DMPRO-Gruppe-B/Effect-Box-PCB/README.md

# Effect-Box-PCB

View this project on [CADLAB.io](https://cadlab.io/project/2128).
