DMPRO-Gruppe-B/Effect-Box-PCB/Effect-Box_bom_status.ods

Done? | Description | References | Value | Footprint | Quantity Per PCB
Done | Unpolarized capacitor | C_iovdd_0 C_iovdd_3 C_iovdd_5 C_vdd_1 | 0.1 µF | C_1206_3216Metric_Pad1.42x1.75mm_HandSolder | 4
Done | Unpolarized capacitor | C27 C31 C35 C38 C39 C41 C42 C44 C45 C46 C47 C49 C51 C53 C55 C57 C59 | 0.47u | C_1206_3216Metric_Pad1.42x1.75mm_HandSolder | 17
Done | Unpolarized capacitor | C_btn_0 C_btn_1 C_btn_2 C_btn_3 C_btn_4 C_btn_5 | 1 nF | C_1206_3216Metric_Pad1.42x1.75mm_HandSolder | 6
Done |  | C_dec1 | 1 µF | C_1206_3216Metric_Pad1.42x1.75mm_HandSolder | 1
Done | Unpolarized capacitor | C_avdd_0 C_avdd_1 | 10 nF | C_1206_3216Metric_Pad1.42x1.75mm_HandSolder | 2
Done | Unpolarized capacitor | C_avdd1 C_iovdd1 C_vdd1 | 10 µF | C_1206_3216Metric_Pad1.42x1.75mm_HandSolder | 3
Done | Unpolarized capacitor | C_disp_1 C_disp_2 C_reset1 | 100 nF | C_1206_3216Metric_Pad1.42x1.75mm_HandSolder | 3
Done | Unpolarized capacitor | C5 C6 C10 C12 C13 C15 C17 C20 C25 C67 C69 C77 C78 | 100n | C_1206_3216Metric_Pad1.42x1.75mm_HandSolder | 13
Done | Unpolarized capacitor | C22 | 100u | C_1206_3216Metric_Pad1.42x1.75mm_HandSolder | 1
Done | Unpolarized capacitor | C8 C9 C14 C64 C65 | 10u | C_1206_3216Metric_Pad1.42x1.75mm_HandSolder | 5
Done | Polarized capacitor, small US symbol | C70 C75 C76 | 10u | C_1206_3216Metric_Pad1.42x1.75mm_HandSolder | 3
Done |  | C_crystal_1 C_crystal_2 | 12 pF | C_1206_3216Metric_Pad1.42x1.75mm_HandSolder | 2
Done | Unpolarized capacitor | C11 C61 C66 C68 | 1u | C_1206_3216Metric_Pad1.42x1.75mm_HandSolder | 4
Done | Polarized capacitor, small US symbol | C71 | 1u | C_1206_3216Metric_Pad1.42x1.75mm_HandSolder | 1
Done | Unpolarized capacitor | C1 | 220n | C_1206_3216Metric_Pad1.42x1.75mm_HandSolder | 1
Done | Unpolarized capacitor | C2 C4 C16 C18 C19 C62 | 22u | C_1206_3216Metric_Pad1.42x1.75mm_HandSolder | 6
Done | Unpolarized capacitor | C7 | 3.3n | C_1206_3216Metric_Pad1.42x1.75mm_HandSolder | 1
Done | Unpolarized capacitor | C21 | 330u | C_1206_3216Metric_Pad1.42x1.75mm_HandSolder | 1
Done | Unpolarized capacitor | C26 C28 C30 C32 C33 C34 C36 C37 C40 C43 | 4.7u | C_1206_3216Metric_Pad1.42x1.75mm_HandSolder | 10
Done | Polarized capacitor, small US symbol | C72 C73 C74 C79 C80 | 4.7u | C_1206_3216Metric_Pad1.42x1.75mm_HandSolder | 5
Done | Unpolarized capacitor | C23 C24 C29 | 47u | C_1206_3216Metric_Pad1.42x1.75mm_HandSolder | 3
Done | Unpolarized capacitor | C3 C81 | 5p | C_1206_3216Metric_Pad1.42x1.75mm_HandSolder | 2
Done |  | Crystal_GND24 | 48MHz | Crystal_SMD_Abracon_ABM8G-4Pin_3.2x2.5mm | 1
Done | Light emitting diode | D1 | LED1 | LED_0805_2012Metric_Pad1.15x1.40mm_HandSolder | 1
Done | Light emitting diode | D2 | LED2 | LED_0805_2012Metric_Pad1.15x1.40mm_HandSolder | 1
Done | Ferrite bead | FB1 | Ferrite_Bead | BLM21AG102SN1D | 1
Done |  | J2 J6 | 26642801RP2 | PinHeader_2x14_P2.54mm_Vertical | 2
Done | Audio Jack, 3 Poles (Stereo / TRS) | J7 J8 | AudioJack3 | Jack_3.5mm_CUI_SJ-3523-SMT_Horizontal | 2
Done | Generic connector, double row, 02x07, odd/even pin numbering scheme (row 1 odd numbers, row 2 even numbers), script generated (kicad-library-utils/schlib/autogen/connector/) | J1 | Conn_02x07_Odd_Even | PinHeader_2x07_P2.00mm_Vertical | 1
Done |  | J5 | Conn_ARM_JTAG_SWD_20 | PinHeader_2x10_P2.54mm_Vertical | 1
Done |  | J3 | FH12A-10S-0.5SH55 | FH12A-10S-0.5SH55 | 1
Done |  | J9 | PJ-006A-SMT | CUI_PJ-006A-SMT | 1
Done | Generic connector, single row, 01x08, script generated (kicad-library-utils/schlib/autogen/connector/) | J10 | Power pins | PinHeader_1x08_P2.54mm_Vertical | 1
Done | Inductor | L1 L2 | 1.5u | IND_VLS5045EX-4R7M | 2
Done | Inductor | L3 | 2.2u | IND_VLS5045EX-4R7M | 1
Done | Resistor | R9 | 1 | R_1206_3216Metric_Pad1.42x1.75mm_HandSolder | 1
Done | Resistor | R_btn_up_0 R_btn_up_1 R_btn_up_2 R_btn_up_3 R_btn_up_4 R_btn_up_5 | 1 MΩ | R_1206_3216Metric_Pad1.42x1.75mm_HandSolder | 6
Done | Resistor | R_disp1 | 10 MΩ | R_1206_3216Metric_Pad1.42x1.75mm_HandSolder | 1
Done | Resistor | R_btn_0 R_btn_1 R_btn_2 R_btn_3 R_btn_4 R_btn_5 R_reset1 | 100 Ω | R_1206_3216Metric_Pad1.42x1.75mm_HandSolder | 7
Done | Resistor | R5 R6 R18 R19 | 100k | R_1206_3216Metric_Pad1.42x1.75mm_HandSolder | 4
Done | Resistor | R10 R11 | 10k | R_1206_3216Metric_Pad1.42x1.75mm_HandSolder | 2
Done | Resistor | R15 | 2.4k | R_1206_3216Metric_Pad1.42x1.75mm_HandSolder | 1
Done | Resistor | R2 R4 R8 | 22.1k | R_1206_3216Metric_Pad1.42x1.75mm_HandSolder | 3
Done | Resistor | R1 | 30.1k | R_1206_3216Metric_Pad1.42x1.75mm_HandSolder | 1
Done | Resistor | R14 | 330 | R_1206_3216Metric_Pad1.42x1.75mm_HandSolder | 1
Done | Resistor | R12 R13 R16 R17 | 4.7k | R_1206_3216Metric_Pad1.42x1.75mm_HandSolder | 4
Done | Resistor | R3 | 6.81k | R_1206_3216Metric_Pad1.42x1.75mm_HandSolder | 1
Done | Resistor | R7 | 73.2k | R_1206_3216Metric_Pad1.42x1.75mm_HandSolder | 1
Done | Resistor | R_LED_1 R_LED_2 | 82 Ω | R_1206_3216Metric_Pad1.42x1.75mm_HandSolder | 2
Done |  | SW0 SW1 SW2 SW3 SW4 SW5 SW6 | SW_Push | FSMSMTR | 7
Done |  | U7 | EFM32GG942F1024 | EFM32GG942F1024 | 1
Done |  | U8 | INA1651IPW | TSSOP-14_4.4x5mm_P0.65mm | 1
Done |  | U10 | LM7805SX_NOPB | LM7805SX&slash_NOPB | 1
Done |  | U9 | PCM3003E | SSOP-24_5.3x8.2mm_P0.65mm | 1
Done |  | U4 | S25FL1 | SOIC-8_5.275x5.275mm_P1.27mm | 1
Done |  | U5 | SiT2024B | SOT-23-5_HandSoldering | 1
Done |  | U2 | TPS54294 | TPS54294PWPR | 1
Done |  | U1 | TPS54325 | TPS54325PWPR | 1
Done | Artix 7 T 100 XC7A100T-FTG256 | U3 | XC7A100T-FTG256 | Xilinx_FTG256 | 1
 | 59
 | 161
 | 161
 | 1
 | 161
 | default
 | ti. 08. okt. 2019 kl. 12.55 +0200
 | /home/hon/Projects/GitHub/DMPRO-Gruppe-B/Effect-Box-PCB/Effect-Box.sch
 | Eeschema 5.1.4-e60b266~84~ubuntu19.04.1
