DMPRO-Gruppe-B/Effect-Box-PCB/(threads)

Thread 14 (2019-09-18):

Communication between FPGA and DAC/ADC

minatst, 2019-09-18:

HON95, 2019-10-01:
Done?

jonassa, 2019-10-01:
Njæ, må implementeres i chisel

On Tue, Oct 1, 2019, 13:52 Håvard O. Nordstrand <notifications@github.com>
wrote:

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

HON95, 2019-10-01:
Men PCB-delen er done? Siden issuen er i Effect-Box-PCB.

jonassa, 2019-10-01:
Ja, sant :)

Closed 2019-10-01.

Thread 17 (2019-09-18):

Decide on footprints for resistors, capacitors, coils etc

minatst, 2019-09-18:

kalkins, 2019-09-20:
It's easier to have the same package for all of the same kind of component. It should be a package that is easy to solder by hand. Size doesn't matter that much, we have room

HON95, 2019-09-24:
Finding electrolytical capacitors and inductors (at DigiKey) with matching footprints is hard ... See Handleliste.

Closed 2019-09-26.

Thread 18 (2019-09-20):

Footprints for switching converters

kalkins, 2019-09-20:
The switching converters weren't in the KiCad library, so they had to be manually drawn. That means that they don't have a built-in footprint either, so we have to find one. The easiest is to use a standard package.

Closed 2019-09-24.
