DMPRO-Gruppe-B/Effect-Box-PCB/Effect-Box.kicad_pcb

## KiCad design Effect-Box.kicad_pcb (2019-10-09)

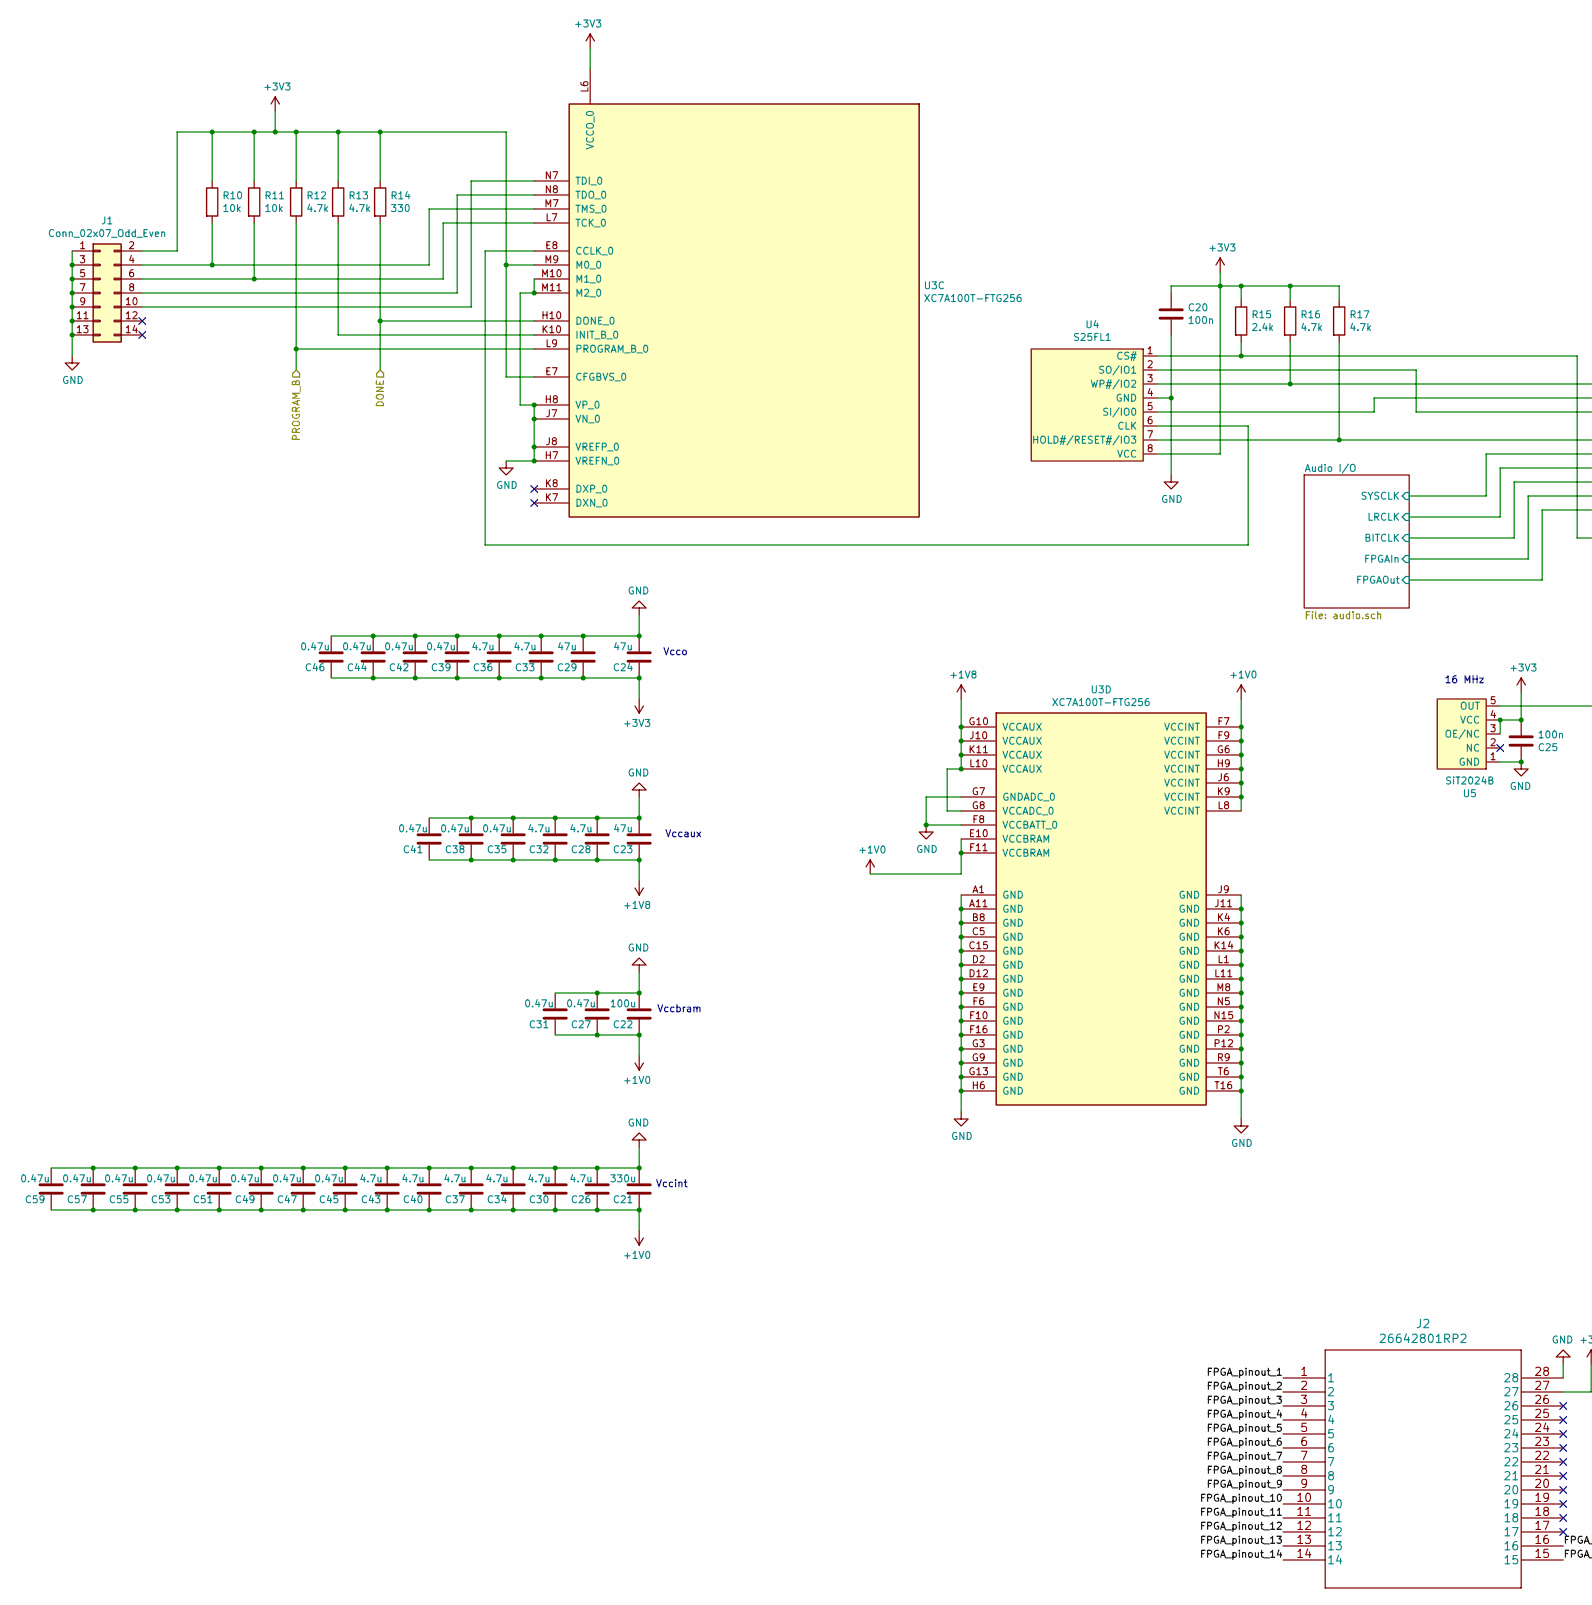
[picture p1: schematic FPGA.sch, part in row 1, column 1]

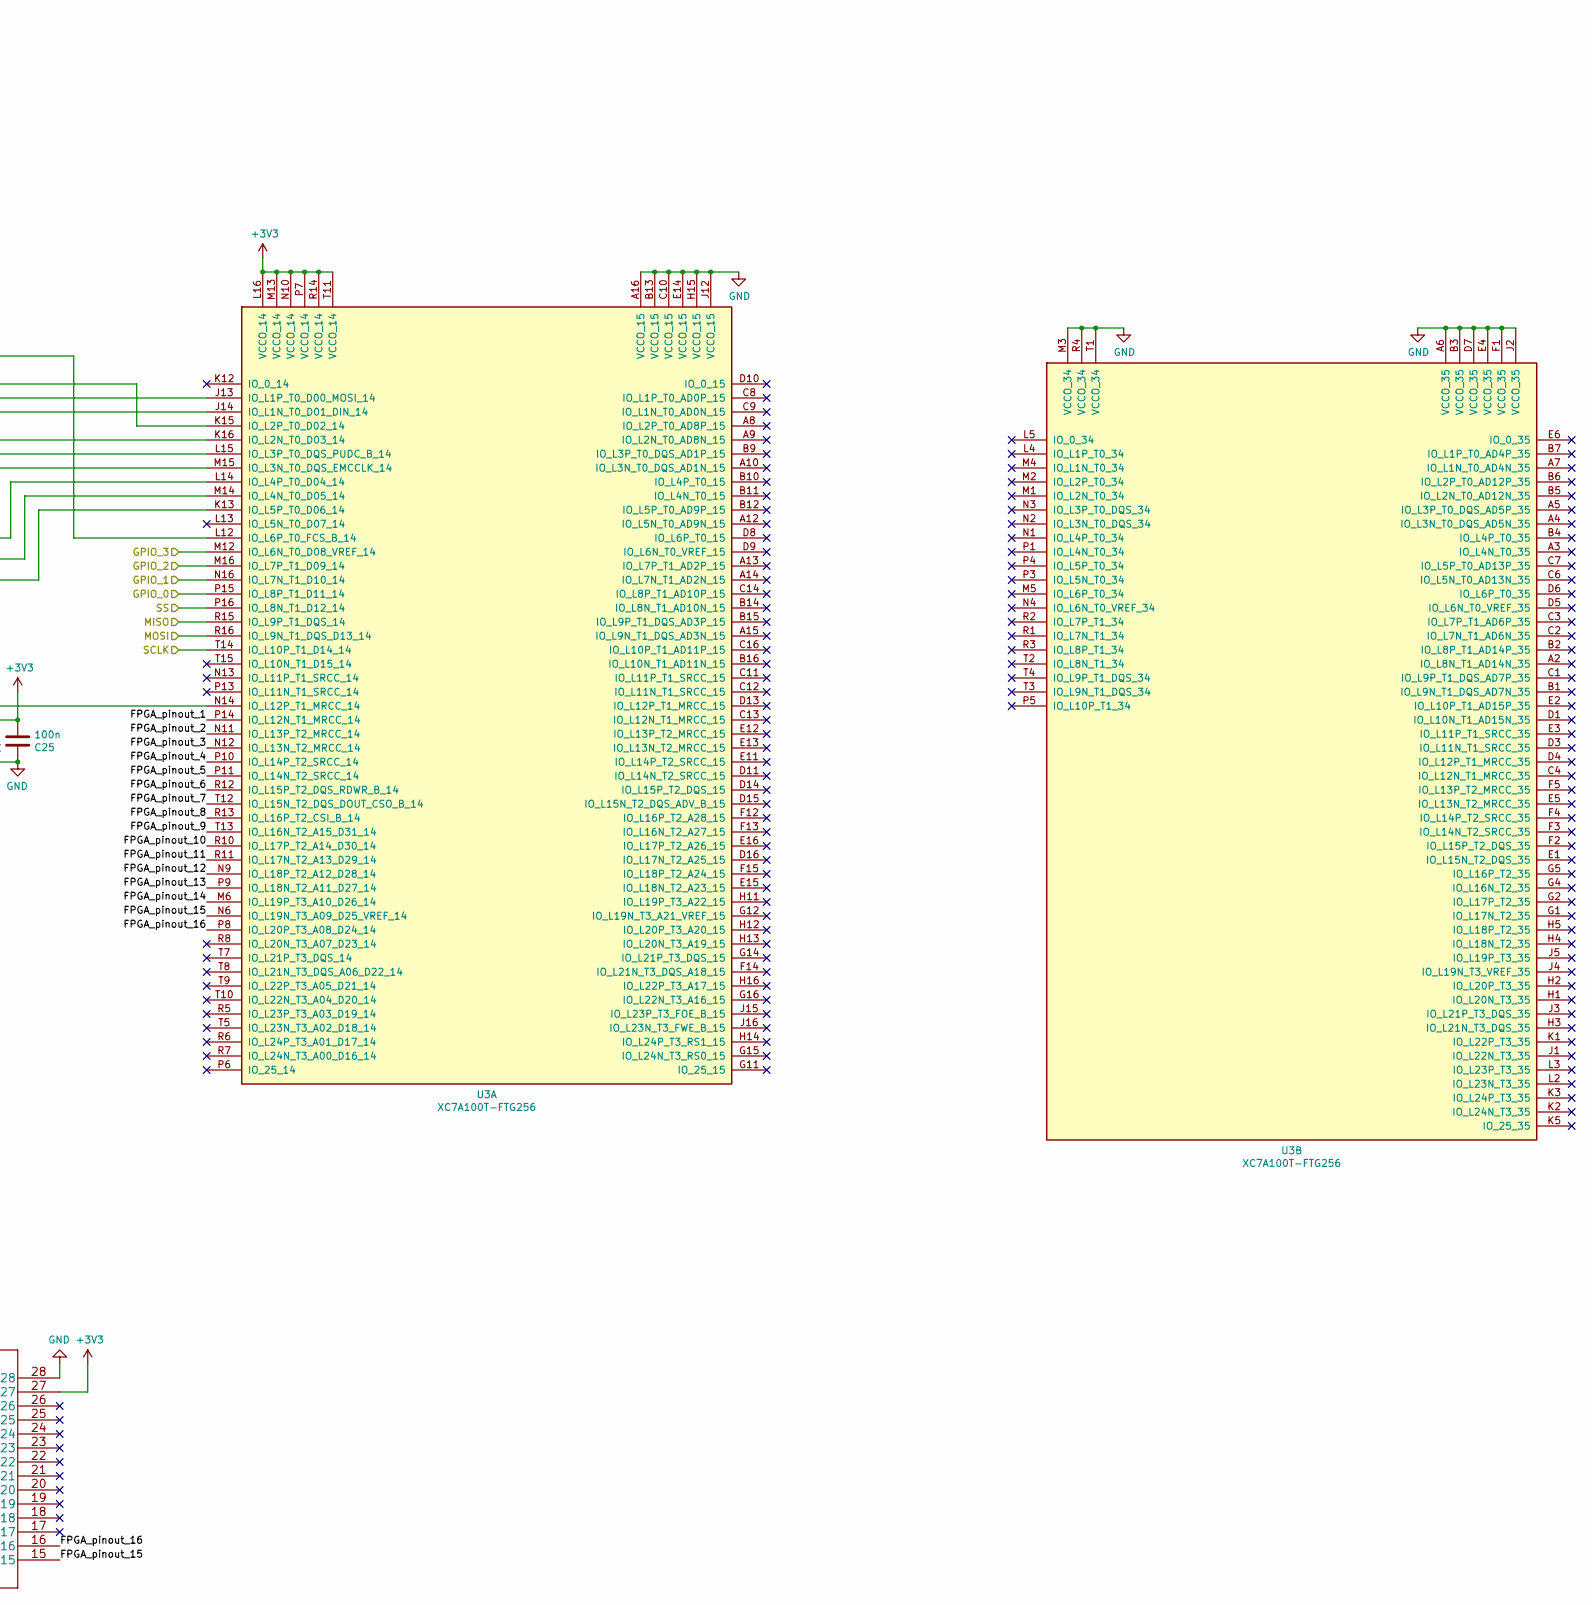
[picture p2: schematic FPGA.sch, part in row 1, column 2]

Parts:
C20, C25: 100n; C_1206_3216Metric_Pad1.42x1.75mm_HandSolder
C21: 330u; C_1206_3216Metric_Pad1.42x1.75mm_HandSolder
C22: 100u; C_1206_3216Metric_Pad1.42x1.75mm_HandSolder
C23, C24, C29: 47u; C_1206_3216Metric_Pad1.42x1.75mm_HandSolder
C26, C28, C30, C32, C33, C34, C36, C37, C40, C43: 4.7u; C_1206_3216Metric_Pad1.42x1.75mm_HandSolder
C27, C31, C35, C38, C39, C41, C42, C44, C45, C46, C47, C49, C51, C53, C55, C57, C59: 0.47u; C_1206_3216Metric_Pad1.42x1.75mm_HandSolder
J1: Conn_02x07_Odd_Even; PinHeader_2x07_P2.00mm_Vertical
J2: 26642801RP2; PinHeader_2x14_P2.54mm_Vertical
R10, R11: 10k; R_1206_3216Metric_Pad1.42x1.75mm_HandSolder
R12, R13, R16, R17: 4.7k; R_1206_3216Metric_Pad1.42x1.75mm_HandSolder
R14: 330; R_1206_3216Metric_Pad1.42x1.75mm_HandSolder
R15: 2.4k; R_1206_3216Metric_Pad1.42x1.75mm_HandSolder
U3: XC7A100T-FTG256; Xilinx_FTG256
U4: S25FL1; SOIC-8_5.275x5.275mm_P1.27mm
U5: SiT2024B; SOT-23-5_HandSoldering

Connections:
+1V0: C21.1, C22.1, C26.1, C27.1, C30.1, C31.1, C34.1, C37.1, C40.1, C43.1, C45.1, C47.1, C49.1, C51.1, C53.1, C55.1, C57.1, C59.1, U3.E10 (VCCBRAM), U3.F7 (VCCINT), U3.F9 (VCCINT), U3.F11 (VCCBRAM), U3.G6 (VCCINT), U3.H9 (VCCINT), U3.J6 (VCCINT), U3.K9 (VCCINT), U3.L8 (VCCINT); also elsewhere on the board
+1V8: C23.1, C28.1, C32.1, C35.1, C38.1, C41.1, U3.G8 (VCCADC_0), U3.G10 (VCCAUX), U3.J10 (VCCAUX), U3.K11 (VCCAUX), U3.L10 (VCCAUX); also elsewhere on the board
/FPGA/Audio I/O/BITCLK: U3.L14 (IO_L4P_T0_D04_14); also elsewhere on the board
/FPGA/Audio I/O/FPGAIn: U3.M14 (IO_L4N_T0_D05_14); also elsewhere on the board
/FPGA/Audio I/O/FPGAOut: U3.K13 (IO_L5P_T0_D06_14); also elsewhere on the board
/FPGA/Audio I/O/LRCLK: U3.M15 (IO_L3N_T0_DQS_EMCCLK_14); also elsewhere on the board
/FPGA/Audio I/O/SYSCLK: U3.L15 (IO_L3P_T0_DQS_PUDC_B_14); also elsewhere on the board
/FPGA/DONE: R14.2, U3.H10 (DONE_0); also elsewhere on the board
/FPGA/FPGA_pinout_1: J2.1, U3.P14 (IO_L12N_T1_MRCC_14)
/FPGA/FPGA_pinout_2: J2.2, U3.N11 (IO_L13P_T2_MRCC_14)
/FPGA/FPGA_pinout_3: J2.3, U3.N12 (IO_L13N_T2_MRCC_14)
/FPGA/FPGA_pinout_4: J2.4, U3.P10 (IO_L14P_T2_SRCC_14)
/FPGA/FPGA_pinout_5: J2.5, U3.P11 (IO_L14N_T2_SRCC_14)
/FPGA/FPGA_pinout_6: J2.6, U3.R12 (IO_L15P_T2_DQS_RDWR_B_14)
/FPGA/FPGA_pinout_7: J2.7, U3.T12 (IO_L15N_T2_DQS_DOUT_CSO_B_14)
/FPGA/FPGA_pinout_8: J2.8, U3.R13 (IO_L16P_T2_CSI_B_14)
/FPGA/FPGA_pinout_9: J2.9, U3.T13 (IO_L16N_T2_A15_D31_14)
/FPGA/FPGA_pinout_10: J2.10, U3.R10 (IO_L17P_T2_A14_D30_14)
/FPGA/FPGA_pinout_11: J2.11, U3.R11 (IO_L17N_T2_A13_D29_14)
/FPGA/FPGA_pinout_12: J2.12, U3.N9 (IO_L18P_T2_A12_D28_14)
/FPGA/FPGA_pinout_13: J2.13, U3.P9 (IO_L18N_T2_A11_D27_14)
/FPGA/FPGA_pinout_14: J2.14, U3.M6 (IO_L19P_T3_A10_D26_14)
/FPGA/FPGA_pinout_15: J2.15, U3.N6 (IO_L19N_T3_A09_D25_VREF_14)
/FPGA/FPGA_pinout_16: J2.16, U3.P8 (IO_L20P_T3_A08_D24_14)
/FPGA/GPIO_0: U3.P15 (IO_L8P_T1_D11_14); also elsewhere on the board
/FPGA/GPIO_1: U3.N16 (IO_L7N_T1_D10_14); also elsewhere on the board
/FPGA/GPIO_2: U3.M16 (IO_L7P_T1_D09_14); also elsewhere on the board
/FPGA/GPIO_3: U3.M12 (IO_L6N_T0_D08_VREF_14); also elsewhere on the board
/FPGA/MISO: U3.R15 (IO_L9P_T1_DQS_14); also elsewhere on the board
/FPGA/MOSI: U3.R16 (IO_L9N_T1_DQS_D13_14); also elsewhere on the board
/FPGA/PROGRAM_B: R12.1, U3.L9 (PROGRAM_B_0); also elsewhere on the board
/FPGA/SCLK: U3.T14 (IO_L10P_T1_D14_14); also elsewhere on the board
/FPGA/SS: U3.P16 (IO_L8N_T1_D12_14); also elsewhere on the board
GND: C20.2, C21.2, C22.2, C23.2, C24.2, C25.1, C26.2, C27.2, C28.2, C29.2, C30.2, C31.2, C32.2, C33.2, C34.2, C35.2, C36.2, C37.2, C38.2, C39.2, C40.2, C41.2, C42.2, C43.2, C44.2, C45.2, C46.2, C47.2, C49.2, C51.2, C53.2, C55.2, C57.2, C59.2, J1.1, J1.3, J1.5, J1.7, J1.9, J1.11, J1.13, J2.28, U3.A1 (GND), U3.A6 (VCCO_35), U3.A11 (GND), U3.A16 (VCCO_15), U3.B3 (VCCO_35), U3.B8 (GND), U3.B13 (VCCO_15), U3.C5 (GND), U3.C10 (VCCO_15), U3.C15 (GND), U3.D2 (GND), U3.D7 (VCCO_35), U3.D12 (GND), U3.E4 (VCCO_35), U3.E9 (GND), U3.E14 (VCCO_15), U3.F1 (VCCO_35), U3.F6 (GND), U3.F8 (VCCBATT_0), U3.F10 (GND), U3.F16 (GND), U3.G3 (GND), U3.G7 (GNDADC_0), U3.G9 (GND), U3.G13 (GND), U3.H6 (GND), U3.H7 (VREFN_0), U3.H8 (VP_0), U3.H15 (VCCO_15), U3.J2 (VCCO_35), U3.J7 (VN_0), U3.J8 (VREFP_0), U3.J9 (GND), U3.J11 (GND), U3.J12 (VCCO_15), U3.K4 (GND), U3.K6 (GND), U3.K14 (GND), U3.L1 (GND), U3.L11 (GND), U3.M3 (VCCO_34), U3.M8 (GND), U3.M10 (M1_0), U3.M11 (M2_0), U3.N5 (GND), U3.N15 (GND), U3.P2 (GND), U3.P12 (GND), U3.R4 (VCCO_34), U3.R9 (GND), U3.T1 (VCCO_34), U3.T6 (GND), U3.T16 (GND), U4.4 (GND), U5.1 (GND); also elsewhere on the board
unnamed: J1.4, R10.2, U3.M7 (TMS_0)
unnamed: J1.6, R11.2, U3.L7 (TCK_0)
unnamed: J1.8, U3.N8 (TDO_0)
unnamed: J1.10, U3.N7 (TDI_0)
unnamed: R13.2, U3.K10 (INIT_B_0)
unnamed: R15.2, U3.L12 (IO_L6P_T0_FCS_B_14), U4.1 (CS#)
unnamed: R16.2, U3.K15 (IO_L2P_T0_D02_14), U4.3 (WP#/IO2)
unnamed: R17.2, U3.K16 (IO_L2N_T0_D03_14), U4.7 (HOLD#/RESET#/IO3)
unnamed: U3.E8 (CCLK_0), U4.6 (CLK)
unnamed: U3.J13 (IO_L1P_T0_D00_MOSI_14), U4.5 (SI/IO0)
unnamed: U3.J14 (IO_L1N_T0_D01_DIN_14), U4.2 (SO/IO1)
unnamed: U3.N14 (IO_L12P_T1_MRCC_14), U5.5 (OUT)

Notes on the sheet:
16 MHz
Vccbram
Vccaux
Vcco
Vccint

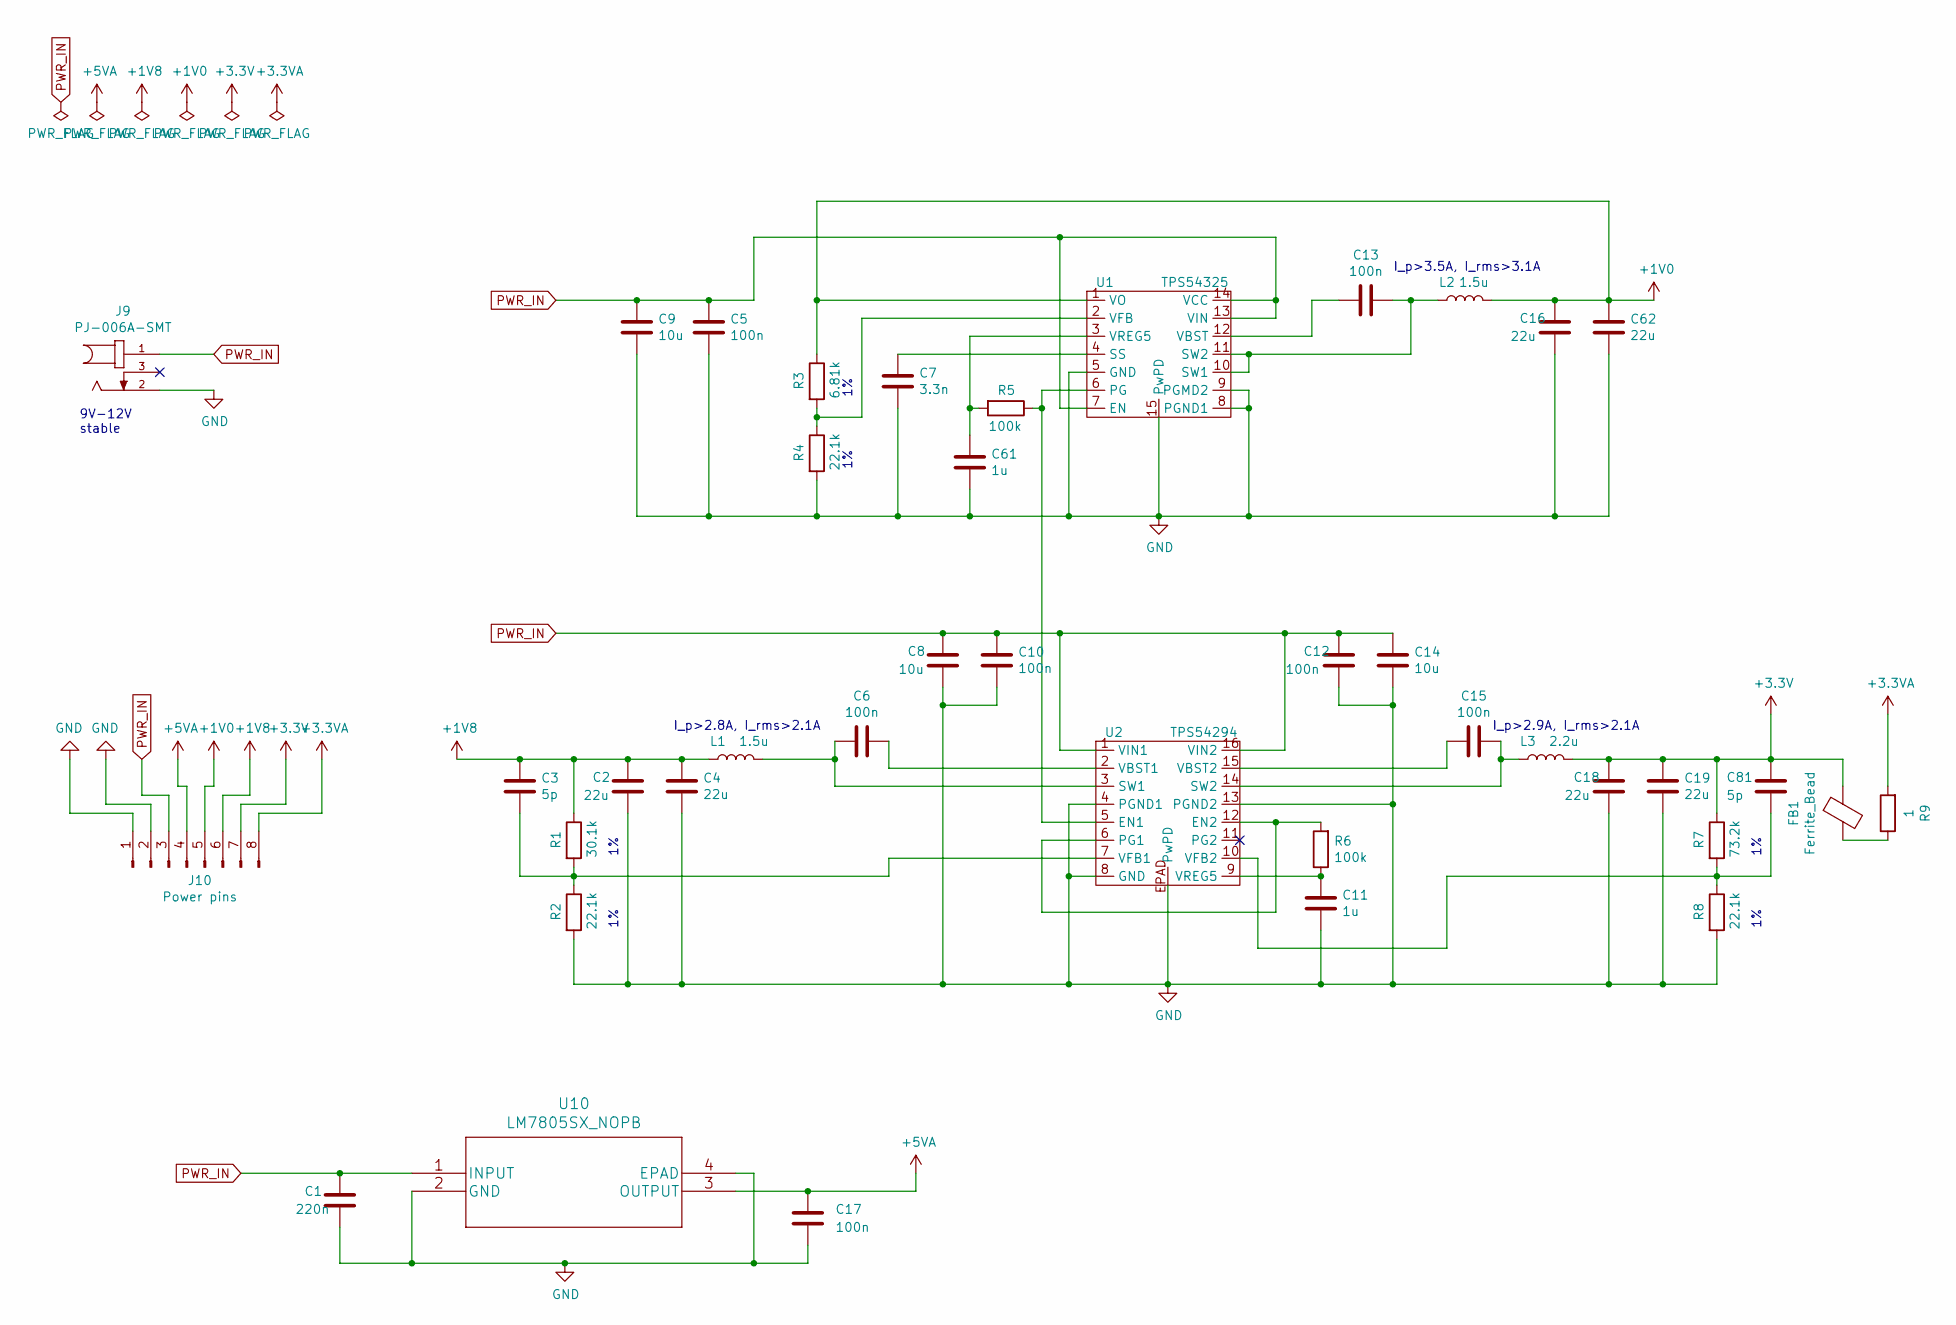
[picture p3: schematic power.sch, Power supply unit]

Parts:
C1: 220n; C_1206_3216Metric_Pad1.42x1.75mm_HandSolder
C2, C4, C16, C18, C19, C62: 22u; C_1206_3216Metric_Pad1.42x1.75mm_HandSolder
C3, C81: 5p; C_1206_3216Metric_Pad1.42x1.75mm_HandSolder
C5, C6, C10, C12, C13, C15, C17: 100n; C_1206_3216Metric_Pad1.42x1.75mm_HandSolder
C7: 3.3n; C_1206_3216Metric_Pad1.42x1.75mm_HandSolder
C8, C9, C14: 10u; C_1206_3216Metric_Pad1.42x1.75mm_HandSolder
C11, C61: 1u; C_1206_3216Metric_Pad1.42x1.75mm_HandSolder
FB1: Ferrite_Bead; BLM21AG102SN1D
J9: PJ-006A-SMT; CUI_PJ-006A-SMT
J10: Power pins; PinHeader_1x08_P2.54mm_Vertical
L1, L2: 1.5u; IND_VLS5045EX-4R7M
L3: 2.2u; IND_VLS5045EX-4R7M
R1: 30.1k; R_1206_3216Metric_Pad1.42x1.75mm_HandSolder
R2, R4, R8: 22.1k; R_1206_3216Metric_Pad1.42x1.75mm_HandSolder
R3: 6.81k; R_1206_3216Metric_Pad1.42x1.75mm_HandSolder
R5, R6: 100k; R_1206_3216Metric_Pad1.42x1.75mm_HandSolder
R7: 73.2k; R_1206_3216Metric_Pad1.42x1.75mm_HandSolder
R9: 1; R_1206_3216Metric_Pad1.42x1.75mm_HandSolder
U1: TPS54325; TPS54325PWPR
U2: TPS54294; TPS54294PWPR
U10: LM7805SX_NOPB; LM7805SX&slash_NOPB

Connections:
+1V0: C16.1, C62.1, J10.5, L2.2, R3.1, U1.1 (VO); also elsewhere on the board
+1V8: C2.1, C3.1, C4.1, J10.6, L1.1, R1.1; also elsewhere on the board
+3.3VA: J10.8, R9.2; also elsewhere on the board
+5VA: C17.1, J10.4, U10.3 (OUTPUT); also elsewhere on the board
GND: C1.2, C2.2, C4.2, C5.2, C7.2, C8.2, C9.2, C10.2, C11.2, C12.2, C14.2, C16.2, C17.2, C18.2, C19.2, C61.2, C62.2, J9.2, J10.1, J10.2, R2.2, R4.2, R8.2, U1.5 (GND), U1.8 (PGND1), U1.9 (PGMD2), U1.15 (PwPD), U2.4 (PGND1), U2.8 (GND), U2.13 (PGND2), U2.EPAD (PwPD), U10.2 (GND), U10.4 (EPAD); also elsewhere on the board
unnamed: C3.2, R1.2, R2.1, U2.7 (VFB1)
unnamed: C6.1, U2.2 (VBST1)
unnamed: C6.2, L1.2, U2.3 (SW1)
unnamed: C7.1, U1.4 (SS)
unnamed: C11.1, R6.1, U2.9 (VREG5)
unnamed: C13.1, L2.1, U1.10 (SW1), U1.11 (SW2)
unnamed: C13.2, U1.12 (VBST)
unnamed: C15.1, L3.1, U2.14 (SW2)
unnamed: C15.2, U2.15 (VBST2)
unnamed: C61.1, R5.2, U1.3 (VREG5)
unnamed: C81.2, R7.2, R8.1, U2.10 (VFB2)
unnamed: FB1.2, R9.1
unnamed: R3.2, R4.1, U1.2 (VFB)
unnamed: R5.1, U1.6 (PG), U2.5 (EN1)
unnamed: R6.2, U2.6 (PG1), U2.12 (EN2)
PWR_IN: C1.1, C5.1, C8.1, C9.1, C10.1, C12.1, C14.1, J9.1, J10.3, U1.7 (EN), U1.13 (VIN), U1.14 (VCC), U2.1 (VIN1), U2.16 (VIN2), U10.1 (INPUT)

Notes on the sheet:
I_p>2.9A, I_rms>2.1A
I_p>2.8A, I_rms>2.1A
I_p>3.5A, I_rms>3.1A
9V-12V stable

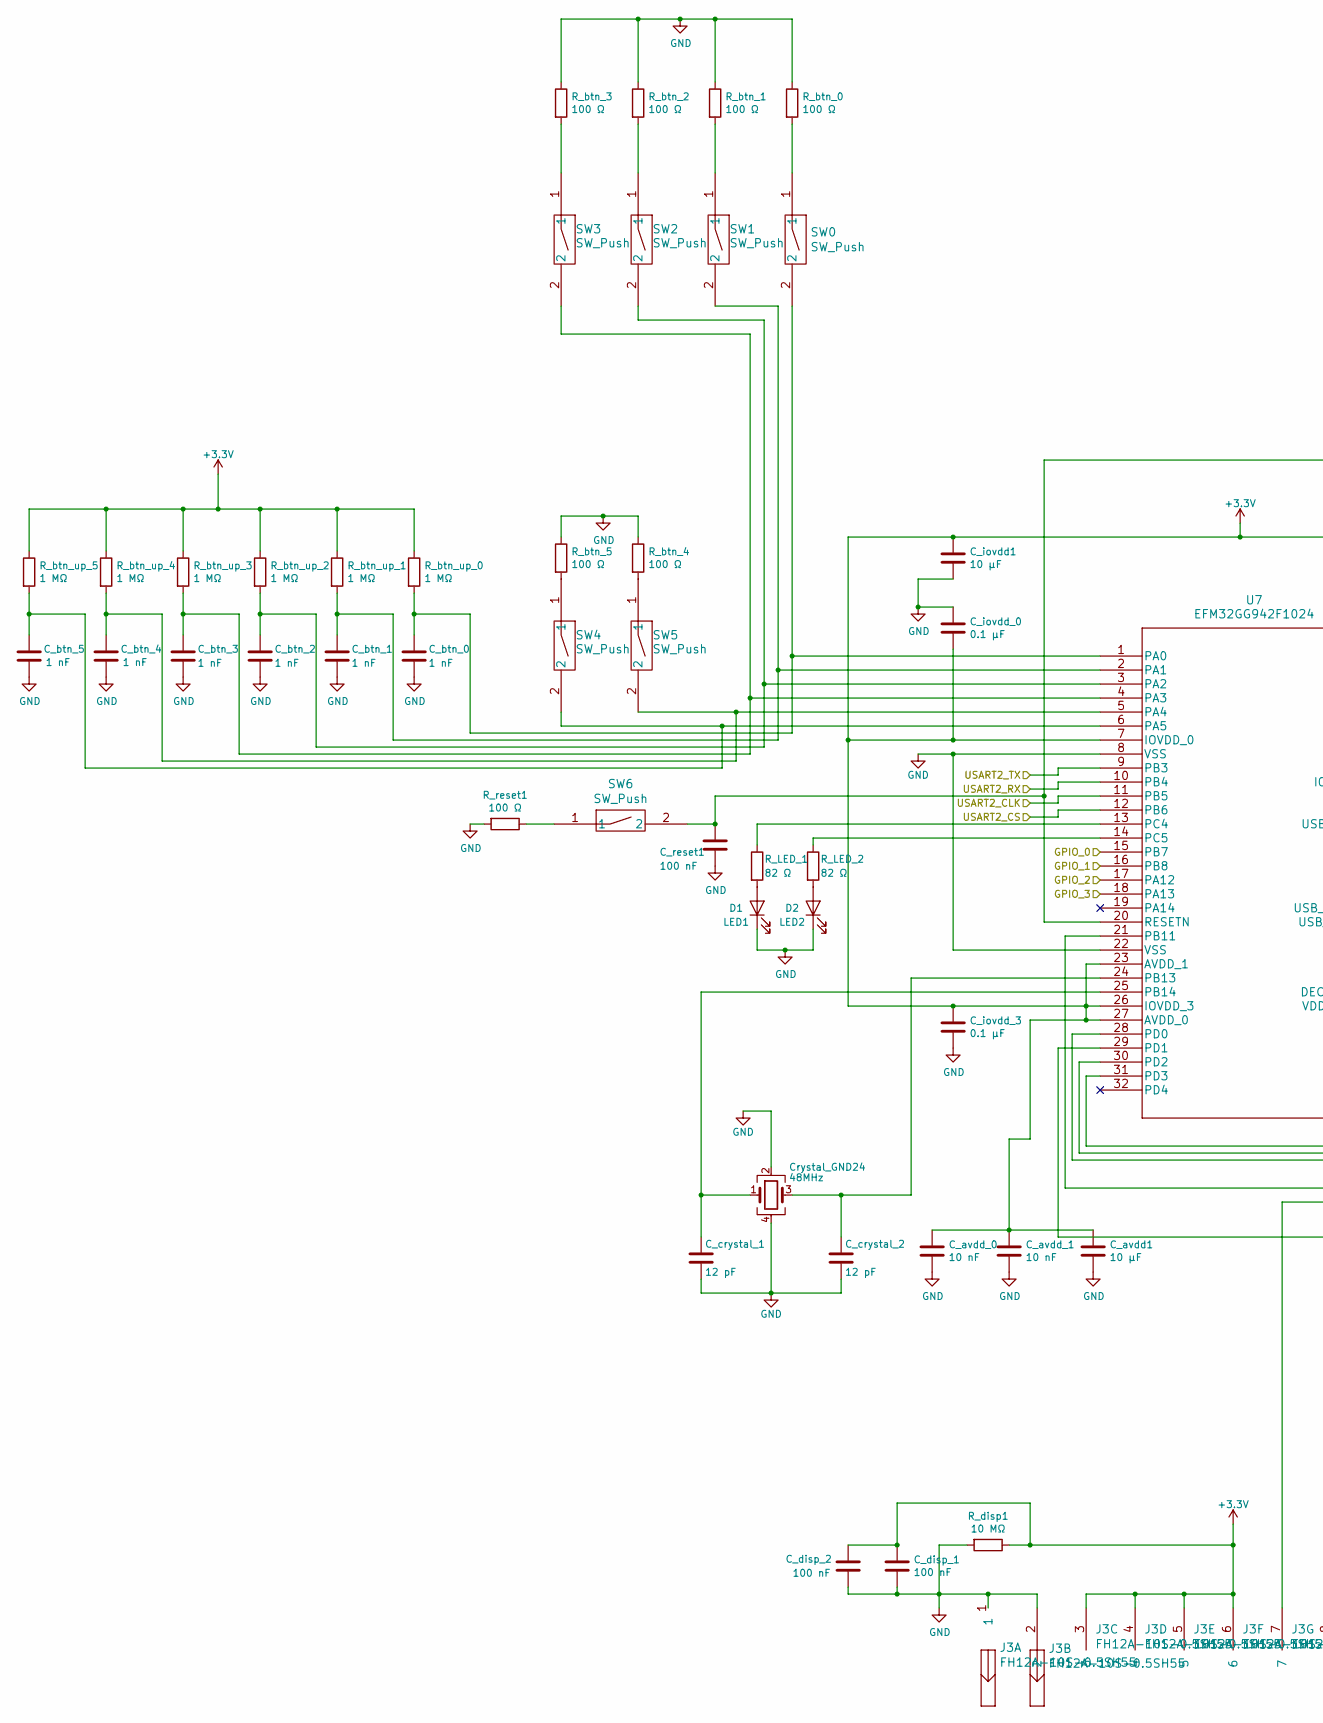
[picture p4: schematic microcontroller.sch, part in row 1, column 1]

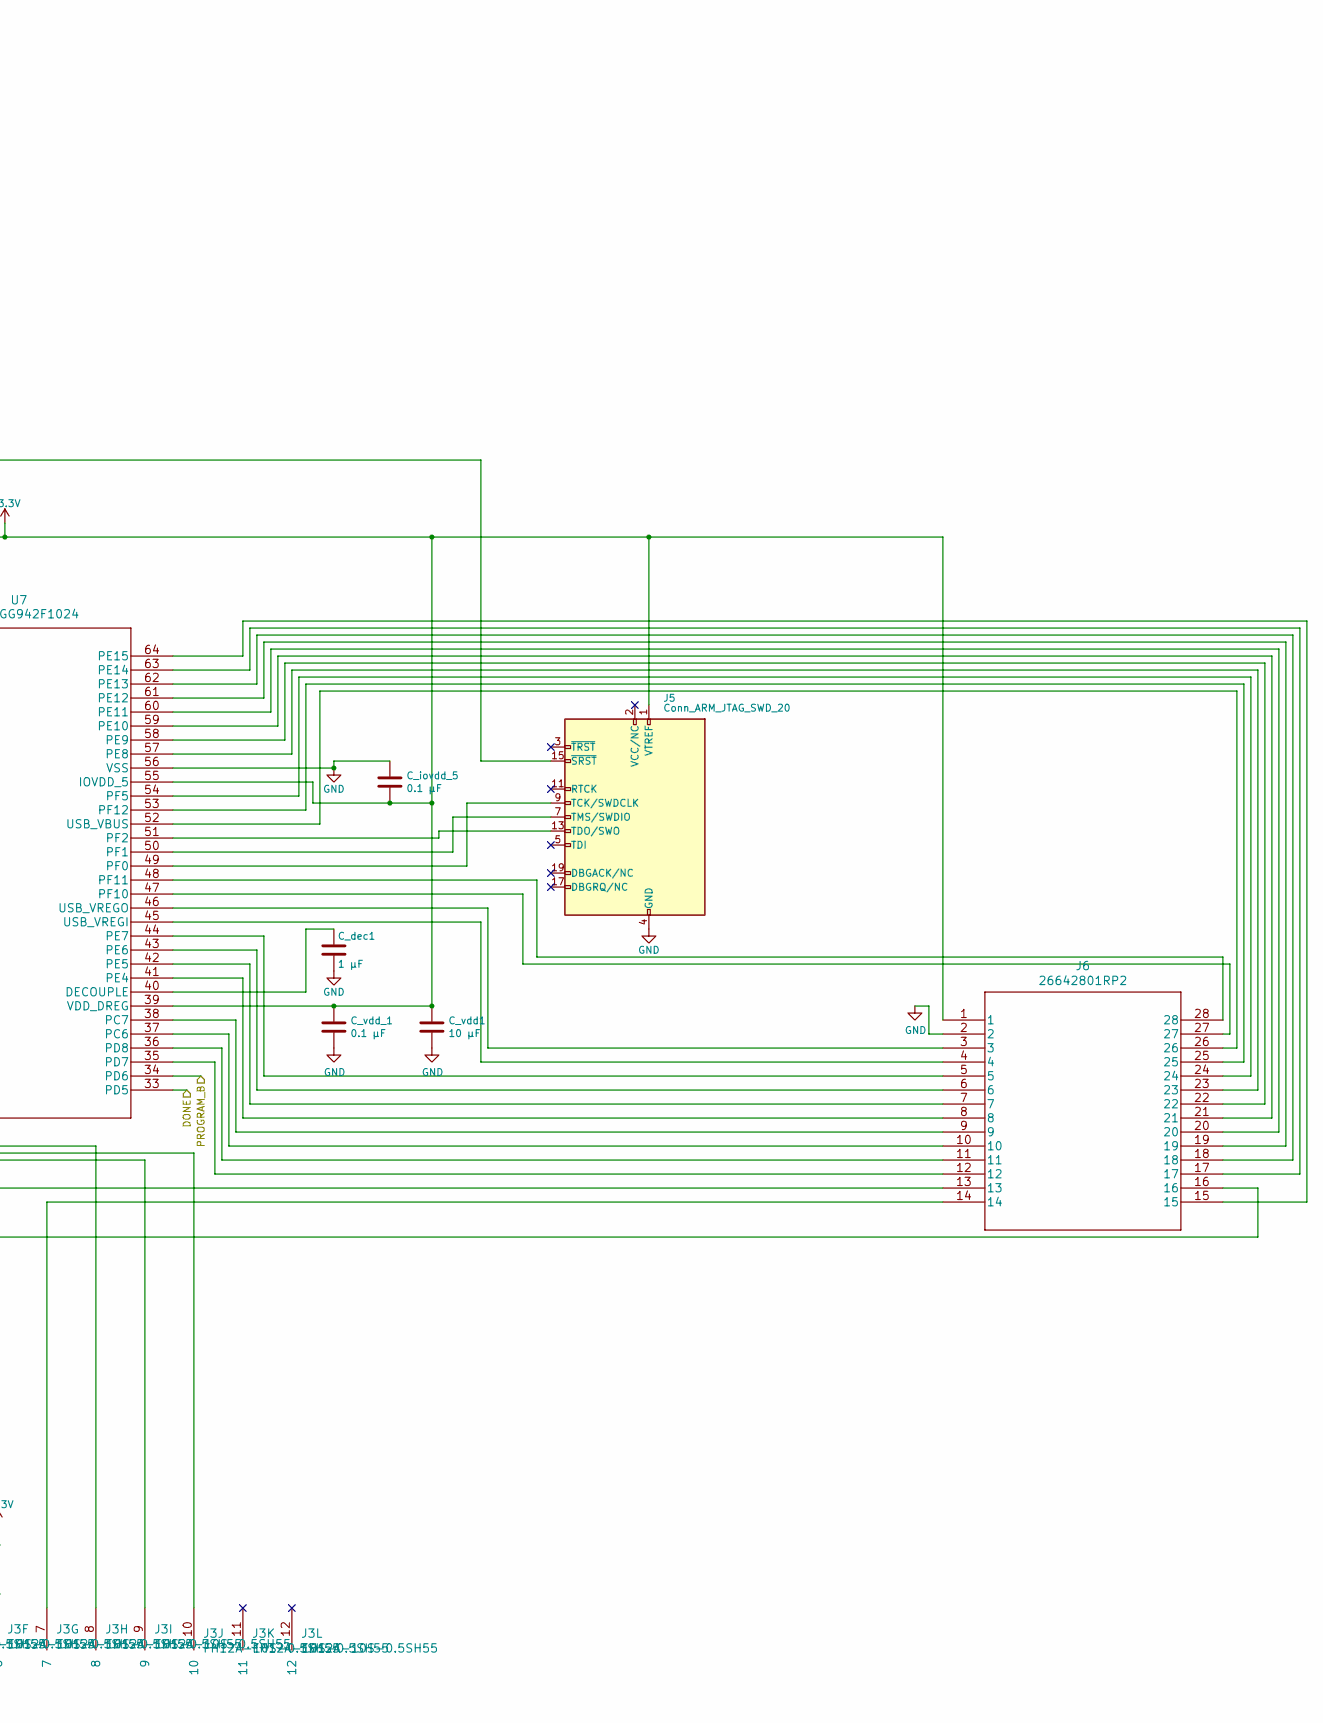
[picture p5: schematic microcontroller.sch, part in row 1, column 2]

Parts:
C_avdd1: 10 µF; C_1206_3216Metric_Pad1.42x1.75mm_HandSolder
C_avdd_0, C_avdd_1: 10 nF; C_1206_3216Metric_Pad1.42x1.75mm_HandSolder
C_btn_0, C_btn_1, C_btn_2, C_btn_3, C_btn_4, C_btn_5: 1 nF; C_1206_3216Metric_Pad1.42x1.75mm_HandSolder
C_crystal_1, C_crystal_2: 12 pF; C_1206_3216Metric_Pad1.42x1.75mm_HandSolder
C_dec1: 1 µF; C_1206_3216Metric_Pad1.42x1.75mm_HandSolder
C_disp_1, C_disp_2: 100 nF; C_1206_3216Metric_Pad1.42x1.75mm_HandSolder
C_iovdd1: 10 µF; C_1206_3216Metric_Pad1.42x1.75mm_HandSolder
C_iovdd_0, C_iovdd_3, C_iovdd_5: 0.1 µF; C_1206_3216Metric_Pad1.42x1.75mm_HandSolder
C_reset1: 100 nF; C_1206_3216Metric_Pad1.42x1.75mm_HandSolder
C_vdd1: 10 µF; C_1206_3216Metric_Pad1.42x1.75mm_HandSolder
C_vdd_1: 0.1 µF; C_1206_3216Metric_Pad1.42x1.75mm_HandSolder
Crystal_GND24: 48MHz; Crystal_SMD_Abracon_ABM8G-4Pin_3.2x2.5mm
D1: LED1; LED_0805_2012Metric_Pad1.15x1.40mm_HandSolder
D2: LED2; LED_0805_2012Metric_Pad1.15x1.40mm_HandSolder
J3: FH12A-10S-0.5SH55
J5: Conn_ARM_JTAG_SWD_20; PinHeader_2x10_P2.54mm_Vertical
J6: 26642801RP2; PinHeader_2x14_P2.54mm_Vertical
R_LED_1, R_LED_2: 82 Ω; R_1206_3216Metric_Pad1.42x1.75mm_HandSolder
R_btn_0, R_btn_1, R_btn_2, R_btn_3, R_btn_4, R_btn_5: 100 Ω; R_1206_3216Metric_Pad1.42x1.75mm_HandSolder
R_btn_up_0, R_btn_up_1, R_btn_up_2, R_btn_up_3, R_btn_up_4, R_btn_up_5: 1 MΩ; R_1206_3216Metric_Pad1.42x1.75mm_HandSolder
R_disp1: 10 MΩ; R_1206_3216Metric_Pad1.42x1.75mm_HandSolder
R_reset1: 100 Ω; R_1206_3216Metric_Pad1.42x1.75mm_HandSolder
SW0, SW1, SW2, SW3, SW4, SW5, SW6: SW_Push; FSMSMTR
U7: EFM32GG942F1024

Connections:
/FPGA/DONE: U7.33 (PD5); also elsewhere on the board
/FPGA/GPIO_0: U7.15 (PB7); also elsewhere on the board
/FPGA/GPIO_1: U7.16 (PB8); also elsewhere on the board
/FPGA/GPIO_2: U7.17 (PA12); also elsewhere on the board
/FPGA/GPIO_3: U7.18 (PA13); also elsewhere on the board
/FPGA/MISO: U7.10 (PB4); also elsewhere on the board
/FPGA/MOSI: U7.9 (PB3); also elsewhere on the board
/FPGA/PROGRAM_B: U7.34 (PD6); also elsewhere on the board
/FPGA/SCLK: U7.11 (PB5); also elsewhere on the board
/FPGA/SS: U7.12 (PB6); also elsewhere on the board
GND: C_avdd1.2, C_avdd_0.2, C_avdd_1.2, C_btn_0.2, C_btn_1.2, C_btn_2.2, C_btn_3.2, C_btn_4.2, C_btn_5.2, C_crystal_1.2, C_crystal_2.2, C_dec1.2, C_disp_1.2, C_disp_2.2, C_iovdd1.2, C_iovdd_0.1, C_iovdd_3.2, C_iovdd_5.1, C_reset1.2, C_vdd1.2, C_vdd_1.2, Crystal_GND24.2, Crystal_GND24.4, D1.1 (K), D2.1 (K), J3.1, J3.2, J5.4 (GND), J5.6 (GND), J5.8 (GND), J5.10 (GND), J5.12 (GND), J5.14 (GND), J5.16 (GND), J5.18 (GND), J5.20 (GND), J6.2, R_btn_0.1, R_btn_1.1, R_btn_2.1, R_btn_3.1, R_btn_4.1, R_btn_5.1, R_disp1.2, R_reset1.2, U7.8 (VSS), U7.22 (VSS), U7.56 (VSS); also elsewhere on the board
unnamed: C_btn_0.1, R_btn_up_0.2, SW0.2, U7.1 (PA0)
unnamed: C_btn_1.1, R_btn_up_1.2, SW1.2, U7.2 (PA1)
unnamed: C_btn_2.1, R_btn_up_2.2, SW2.2, U7.3 (PA2)
unnamed: C_btn_3.1, R_btn_up_3.2, SW3.2, U7.4 (PA3)
unnamed: C_btn_4.1, R_btn_up_4.2, SW5.2, U7.5 (PA4)
unnamed: C_btn_5.1, R_btn_up_5.2, SW4.2, U7.6 (PA5)
unnamed: C_crystal_1.1, Crystal_GND24.1, U7.25 (PB14)
unnamed: C_crystal_2.1, Crystal_GND24.3, U7.24 (PB13)
unnamed: C_dec1.1, U7.40 (DECOUPLE)
unnamed: C_reset1.1, J5.15 (~SRST~), SW6.2, U7.20 (RESETN)
unnamed: D1.2 (A), R_LED_1.2
unnamed: D2.2 (A), R_LED_2.2
unnamed: J3.7, J6.14
unnamed: J3.8, U7.31 (PD3)
unnamed: J3.9, U7.28 (PD0)
unnamed: J3.10, U7.30 (PD2)
unnamed: J5.7 (TMS/SWDIO), U7.50 (PF1)
unnamed: J5.9 (TCK/SWDCLK), U7.49 (PF0)
unnamed: J5.13 (TDO/SWO), U7.51 (PF2)
unnamed: J6.3, U7.46 (USB_VREGO)
unnamed: J6.4, U7.45 (USB_VREGI)
unnamed: J6.5, U7.44 (PE7)
unnamed: J6.6, U7.43 (PE6)
unnamed: J6.7, U7.42 (PE5)
unnamed: J6.8, U7.41 (PE4)
unnamed: J6.9, U7.38 (PC7)
unnamed: J6.10, U7.37 (PC6)
unnamed: J6.11, U7.36 (PD8)
unnamed: J6.12, U7.35 (PD7)
unnamed: J6.13, U7.21 (PB11)
unnamed: J6.15, U7.64 (PE15)
unnamed: J6.16, U7.29 (PD1)
unnamed: J6.17, U7.63 (PE14)
unnamed: J6.18, U7.62 (PE13)
unnamed: J6.19, U7.61 (PE12)
unnamed: J6.20, U7.60 (PE11)
unnamed: J6.21, U7.59 (PE10)
unnamed: J6.22, U7.58 (PE9)
unnamed: J6.23, U7.57 (PE8)
unnamed: J6.24, U7.54 (PF5)
unnamed: J6.25, U7.53 (PF12)
unnamed: J6.26, U7.52 (USB_VBUS)
unnamed: J6.27, U7.47 (PF10)
unnamed: J6.28, U7.48 (PF11)
unnamed: R_LED_1.1, U7.13 (PC4)
unnamed: R_LED_2.1, U7.14 (PC5)
unnamed: R_btn_0.2, SW0.1
unnamed: R_btn_1.2, SW1.1
unnamed: R_btn_2.2, SW2.1
unnamed: R_btn_3.2, SW3.1
unnamed: R_btn_4.2, SW5.1
unnamed: R_btn_5.2, SW4.1
unnamed: R_reset1.1, SW6.1

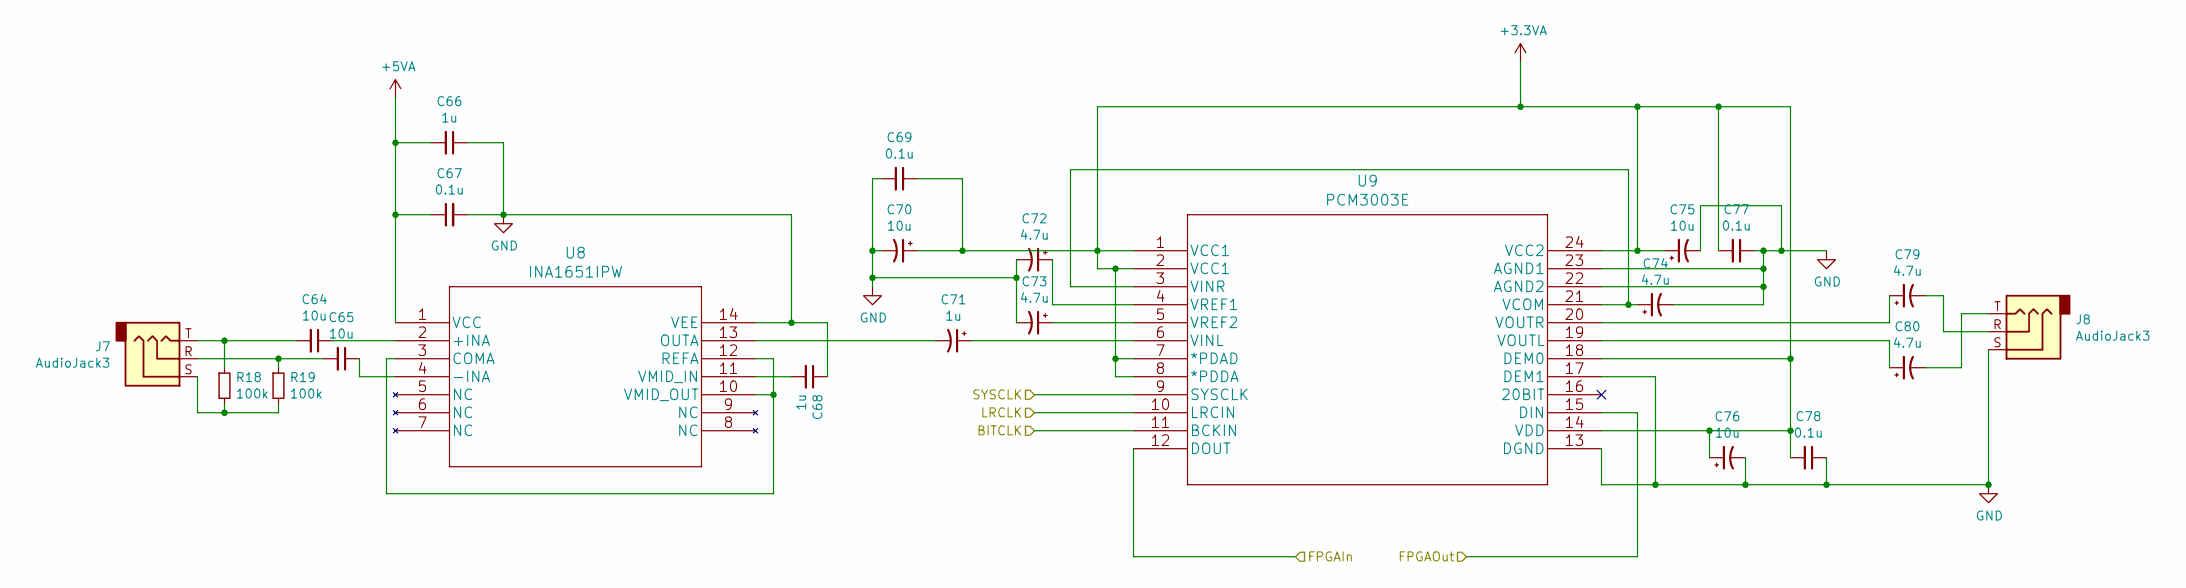
[picture p6: schematic audio.sch]

Parts:
C64, C65, C70, C75, C76: 10u; C_1206_3216Metric_Pad1.42x1.75mm_HandSolder
C66, C68, C71: 1u; C_1206_3216Metric_Pad1.42x1.75mm_HandSolder
C67, C69, C77, C78: 0.1u; C_1206_3216Metric_Pad1.42x1.75mm_HandSolder
C72, C73, C74, C79, C80: 4.7u; C_1206_3216Metric_Pad1.42x1.75mm_HandSolder
J7, J8: AudioJack3; Jack_3.5mm_CUI_SJ-3523-SMT_Horizontal
R18, R19: 100k; R_1206_3216Metric_Pad1.42x1.75mm_HandSolder
U8: INA1651IPW; TSSOP-14_4.4x5mm_P0.65mm
U9: PCM3003E; SSOP-24_5.3x8.2mm_P0.65mm

Connections:
+3.3VA: C69.1, C70.1, C75.1, C76.1, C77.2, C78.2, U9.1 (VCC1), U9.2 (VCC1), U9.7 (*PDAD), U9.8 (*PDDA), U9.14 (VDD), U9.18 (DEM0), U9.24 (VCC2); also elsewhere on the board
+5VA: C66.2, C67.1, U8.1 (VCC); also elsewhere on the board
/FPGA/Audio I/O/BITCLK: U9.11 (BCKIN); also elsewhere on the board
/FPGA/Audio I/O/FPGAIn: U9.12 (DOUT); also elsewhere on the board
/FPGA/Audio I/O/FPGAOut: U9.15 (DIN); also elsewhere on the board
/FPGA/Audio I/O/LRCLK: U9.10 (LRCIN); also elsewhere on the board
/FPGA/Audio I/O/SYSCLK: U9.9 (SYSCLK); also elsewhere on the board
GND: C66.1, C67.2, C68.1, C69.2, C70.2, C72.2, C73.2, C74.2, C75.2, C76.2, C77.1, C78.1, J8.S, U8.14 (VEE), U9.13 (DGND), U9.17 (DEM1), U9.22 (AGND2), U9.23 (AGND1); also elsewhere on the board
unnamed: C64.1, U8.2 (+INA)
unnamed: C64.2, J7.T, R18.1
unnamed: C65.1, U8.4 (-INA)
unnamed: C65.2, J7.R, R19.1
unnamed: C68.2, U8.11 (VMID_IN)
unnamed: C71.1, U9.6 (VINL)
unnamed: C71.2, U8.13 (OUTA)
unnamed: C72.1, U9.4 (VREF1)
unnamed: C73.1, U9.5 (VREF2)
unnamed: C74.1, U9.3 (VINR), U9.21 (VCOM)
unnamed: C79.1, U9.20 (VOUTR)
unnamed: C79.2, J8.R
unnamed: C80.1, U9.19 (VOUTL)
unnamed: C80.2, J8.T
unnamed: J7.S, R18.2, R19.2
unnamed: U8.3 (COMA), U8.10 (VMID_OUT), U8.12 (REFA)

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
