DMPRO-Gruppe-B/Effect-Box-PCB/Effect-Box.kicad_pcb

## KiCad design Effect-Box.kicad_pcb (continued)

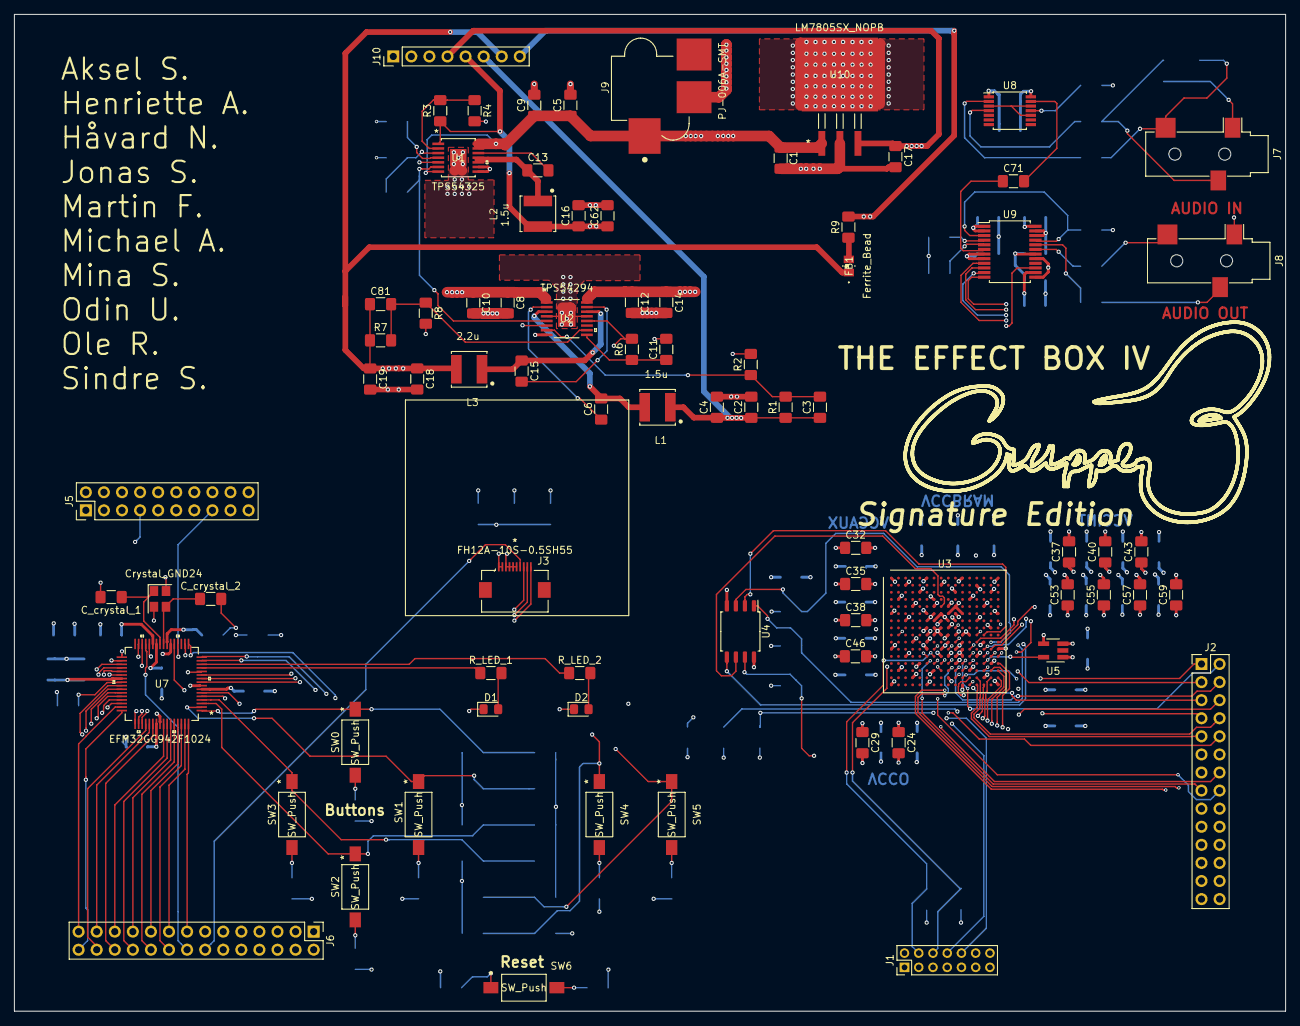
[picture p7: board Effect-Box.kicad_pcb from above]

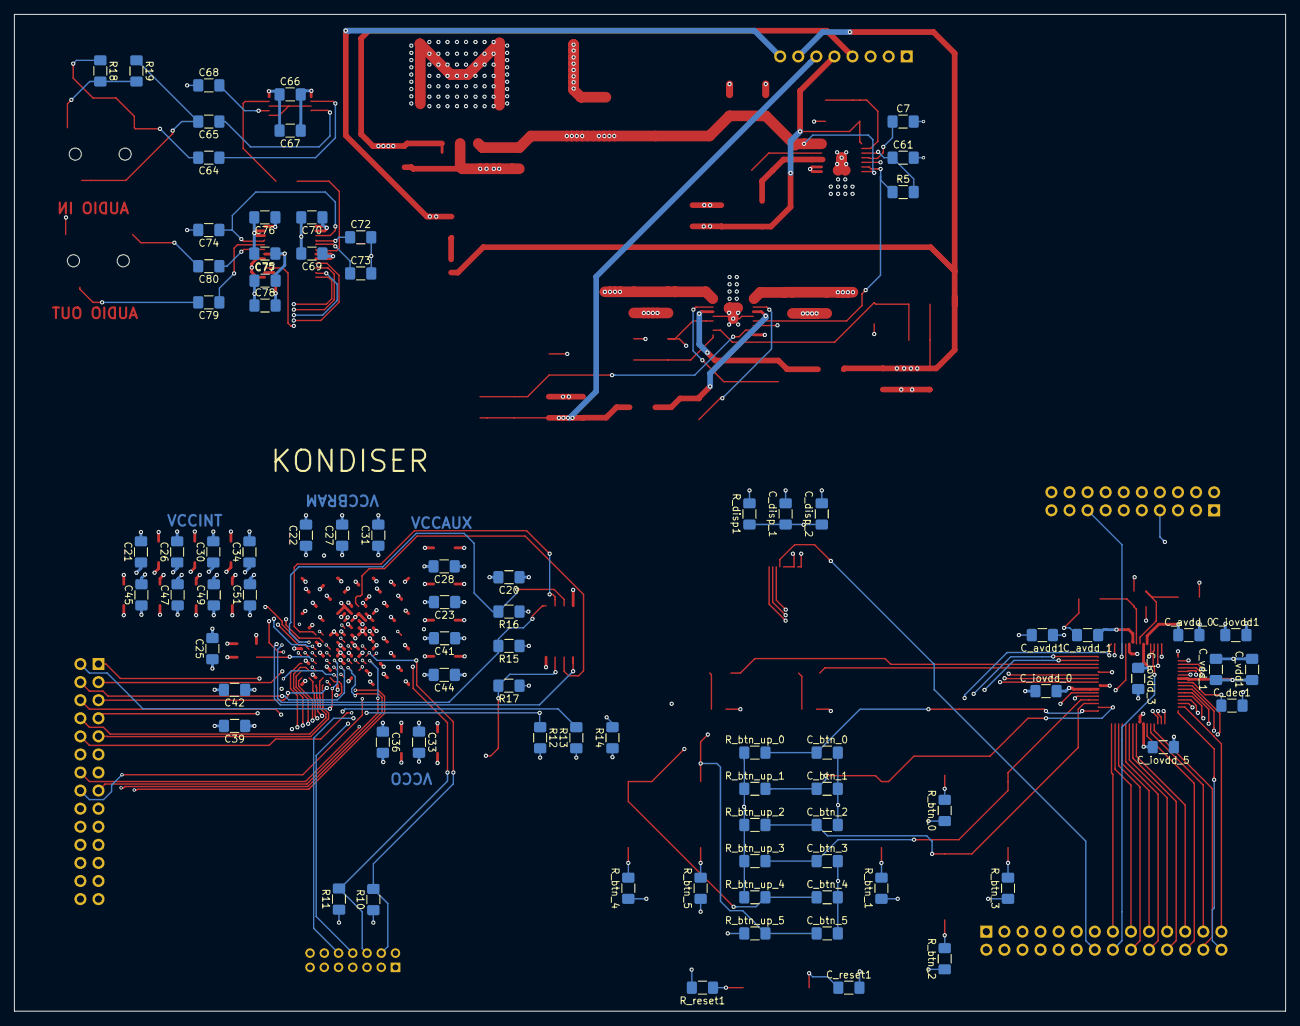
[picture p8: board Effect-Box.kicad_pcb from below]

Board: 6 copper layers, 178.6 x 140.0 mm, 161 parts (83 on the bottom side), 134 nets.
