DMPRO-Gruppe-B/Effect-Box-PCB/(commit log)

2019-09-15 Add separate schema files for subcomponents
    [FPGA.sch, audio.sch, microcontroller.sch, power.sch]
2019-09-16 Add FPGA schematic and set up decoupling capacitors
    [FPGA.sch]
2019-09-17 Add PSU
    [power.sch]
2019-09-17 Fix PSU warnings
    [power.sch]
2019-09-17 Update PSU files
    [power.sch]
2019-09-17 Add microcontroller
    [Effect-Box.sch, FPGA.sch, audio.sch, microcontroller.sch, power.sch]
2019-09-17 Add autoupdated files
    Guess we need this....
    [Effect-Box.sch, FPGA.sch, audio.sch, microcontroller.sch, power.sch]
2019-09-17 Add capacitors
    [FPGA.sch, microcontroller.sch]
2019-09-17 Fix all the things
    [power.sch]
2019-09-17 Add avdd capacitors
    [microcontroller.sch, power.sch]
2019-09-20 Set up FPGA power and enable I/O banks
    [FPGA.sch]
2019-09-20 Add oscillator
    [FPGA.sch]
2019-09-20 Add PSU lib footprints
    [power.sch]
2019-09-20 Add footprints for real (such pain)
    [power.sch]
2019-09-20 Use another oscillator, with a custom symbol
    [FPGA.sch]
2019-09-24 Add lcd schematic
    [microcontroller.sch]
2019-09-24 Move FPGA JTAG schematic to subsheet
    [Effect-Box.sch, FPGA.sch, audio.sch, fpga_jtag.sch, microcontroller.sch, power.sch]
2019-09-24 Add JTAG connector
    [fpga_jtag.sch, microcontroller.sch]
2019-09-24 Switch FPGA I/O banks, and add subsheet for SRAM
    [Effect-Box.sch, FPGA.sch, audio.sch, fpga_jtag.sch, fpga_sram.sch, microcontroller.sch, power.sch]
2019-09-24 Add FPGA Flash
    [fpga_jtag.sch, fpga_sram.sch]
2019-09-24 Export PSU components as libs
    [power.sch]
2019-09-24 Change PSU
    [power.sch]
2019-09-24 Connect SRAM and FPGA
    [fpga_sram.sch]
2019-09-24 Connect EXTCOMIN to LETIMER
    [microcontroller.sch]
2019-09-24 Change power symbol
    [fpga_sram.sch]
2019-09-24 Connect LEDs
    [microcontroller.sch]
2019-09-24 Connect reset button
    [microcontroller.sch]
2019-09-24 Connect button grid
    [microcontroller.sch]
2019-09-24 Add hierarchical labels
    [microcontroller.sch]
2019-09-24 Reorganize FPGA schematic
    [Effect-Box.sch, FPGA.sch, audio.sch, fpga_jtag.sch, fpga_sram.sch, microcontroller.sch, power.sch]
2019-09-24 Prepare FPGA I/O pins
    [Effect-Box.sch, FPGA.sch]
2019-09-25 Reorganize libs and add more footprints
2019-09-25 Add more footprints
2019-09-25 Replace footprint
2019-09-25 Update footprints for vregs
    [power.sch]
2019-09-26 Connect MCU to FPGA
    [Effect-Box.sch, microcontroller.sch, power.sch]
2019-09-26 Add pullup resistors and capacitors to buttons
    [microcontroller.sch]
2019-09-26 Add crystal values
    [microcontroller.sch]
2019-09-26 Add NC symbols
    [Effect-Box.sch, microcontroller.sch]
2019-09-26 Add 2x13 pin header
    [Effect-Box.sch, microcontroller.sch]
2019-09-26 Added symbols for driver and receiver
2019-09-26 Progress on audio scheme
    [audio.sch]
2019-09-27 More schemes
    [audio.sch, audio2.sch, audio_bias_divider.sch, audio_common.sch]
2019-09-27 Commit including other schemes
    [Effect-Box.sch, FPGA.sch, microcontroller.sch, power.sch]
2019-09-27 Add PSU 5VA and pin headers and change power symbols
    [power.sch]
2019-09-27 Add some footprints
    [power.sch]
2019-09-27 Add input capacitor to 5VA
    [power.sch]
2019-09-27 Remove extra input capacitors
    [power.sch]
2019-09-27 Re-add required cap for 5VA
    [power.sch]
2019-09-27 FPGA cleanup
    [Effect-Box.sch, FPGA.sch, microcontroller.sch, power.sch]
2019-09-27 Add ferrite bead footprints
    [power.sch]
2019-09-27 Minor FPGA and MCU fixes
    [Effect-Box.sch, FPGA.sch, microcontroller.sch]
2019-09-27 Add LM7805 symbol and footprint
2019-09-27 All the files
    [Effect-Box.sch, FPGA.sch, audio.sch, audio2.sch, audio_bias_divider.sch, audio_common.sch, microcontroller.sch, power.sch]
2019-09-27 All the updates
    [Effect-Box.sch, FPGA.sch, audio.sch, audio2.sch, audio_bias_divider.sch, audio_common.sch, microcontroller.sch, power.sch]
2019-09-27 Add various footprints
    [FPGA.sch, microcontroller.sch, power.sch]
2019-09-27 Connect DAC/ADC to FPGA
    [Effect-Box.sch, FPGA.sch, audio.sch, audio2.sch, audio_bias_divider.sch, audio_common.sch, power.sch]
2019-09-27 Fix LCD connector
    [microcontroller.sch]
2019-09-27 Add audio jack footprint
    [audio.sch, microcontroller.sch, power.sch]
2019-09-27 Remove USB jack, add power jack
    [power.sch]
2019-09-27 Wire 5V vreg
    [power.sch]
2019-09-27 Add button schematic and footprint
    [microcontroller.sch]
2019-09-27 Add led footprint
    [microcontroller.sch]
2019-09-28 Update annotations and footprints
    [audio.sch, power.sch]
2019-09-28 Organize symbol and footprint files
2019-09-28 Minor unrelated fixes
    [audio.sch, microcontroller.sch]
2019-09-28 Add efm and button footprints
    [microcontroller.sch]
2019-09-28 Minor fixes
    [microcontroller.sch]
2019-09-28 Fix pin headers
    [FPGA.sch, microcontroller.sch]
2019-09-28 Add lcd footprint
2019-09-28 Fix all footprints
    [audio.sch, microcontroller.sch]
2019-09-28 Add JTAG footprint
    [microcontroller.sch]
2019-09-28 Fix ERC issues
    [audio.sch]
2019-09-28 Add PCBNEW drawing
    [Effect-Box.kicad_pcb]
2019-09-28 Organize components and fix minor issues
    [Effect-Box.kicad_pcb, FPGA.sch, microcontroller.sch, power.sch]
2019-09-28 Organize DAC/ADC
    [Effect-Box.kicad_pcb]
2019-09-28 Organize PSU
    [Effect-Box.kicad_pcb]
2019-09-28 Begin moving components to the back plane
    [Effect-Box.kicad_pcb]
2019-09-29 Route DAC/ADC
    [Effect-Box.kicad_pcb]
2019-09-29 Partially route FPGA
    [Effect-Box.kicad_pcb, FPGA.sch, microcontroller.sch, power.sch]
2019-09-29 Route PSU
    [Effect-Box.kicad_pcb, power.sch]
2019-09-29 Partially route MCU
    [Effect-Box.kicad_pcb]
2019-09-29 Route MCU header
    [Effect-Box.kicad_pcb]
2019-09-29 Route rest of MCU header
    [Effect-Box.kicad_pcb]
2019-09-29 Route MCU to FPGA
    [Effect-Box.kicad_pcb]
2019-09-29 Route FPGA to DAC/ADC
    [Effect-Box.kicad_pcb]
2019-09-29 Partially route FPGA pinout
    [Effect-Box.kicad_pcb, FPGA.sch]
2019-09-29 Set up ground layer
    [Effect-Box.kicad_pcb]
2019-09-29 Set up power layer
    [Effect-Box.kicad_pcb]
2019-09-29 Forgot to save. Fixed some power and routing stuff
    [Effect-Box.kicad_pcb]
2019-09-30 Move vias away from pads around MCU, LCD and buttons
    [Effect-Box.kicad_pcb]
2019-09-30 Recalculate VCC layer
    [Effect-Box.kicad_pcb]
2019-09-30 New via and drill sizes
2019-09-30 Reroute FPGA
    [Effect-Box.kicad_pcb]
2019-09-30 Fix vias for PSU
    [Effect-Box.kicad_pcb]
2019-09-30 Fix vias for audio
    [Effect-Box.kicad_pcb]
2019-09-30 Finish PCB wiring
    [Effect-Box.kicad_pcb, FPGA.sch]
2019-09-30 Add gruppe b logo
    [Effect-Box.kicad_pcb]
2019-09-30 Add names
    [Effect-Box.kicad_pcb]
2019-09-30 Add edge cuts
    [Effect-Box.kicad_pcb]
2019-09-30 Update GND and VCC fills
    [Effect-Box.kicad_pcb]
2019-10-01 Start fixing PCB
    [Effect-Box.kicad_pcb]
2019-10-02 Add new filled zones
    [Effect-Box.kicad_pcb]
2019-10-02 Fix PSU stuff
    [Effect-Box.kicad_pcb]
2019-10-03 Fix FPGA caps
    [Effect-Box.kicad_pcb]
2019-10-03 Fix FPGA traces
    [Effect-Box.kicad_pcb]
2019-10-03 Fix audio part errors
    [Effect-Box.kicad_pcb]
2019-10-03 Fix MCU
    [Effect-Box.kicad_pcb]
2019-10-03 Fix disconnected invisible pointless object
    [Effect-Box.kicad_pcb]
2019-10-03 Add more power output vias
    [Effect-Box.kicad_pcb]
2019-10-03 Refill zones
    [Effect-Box.kicad_pcb]
2019-10-03 Add more vreg pad thermal vias
    [Effect-Box.kicad_pcb]
2019-10-03 Move silkscreen text away from solder pads
    [Effect-Box.kicad_pcb]
2019-10-03 Fix more silkscreen and reimport from schematic
    [Effect-Box.kicad_pcb]
2019-10-04 Move enev more silkscreen
    [Effect-Box.kicad_pcb]
2019-10-04 Move some silk again
    [Effect-Box.kicad_pcb]
2019-10-08 Add BOM status sheet for keeping track of what is added
    [Effect-Box_bom_status.ods]
2019-10-09 Update BOM status doc
    [Effect-Box.kicad_pcb, Effect-Box_bom_status.ods]
2019-10-09 Update BOM status sheet
    [Effect-Box_bom_status.ods]
